Haolun123/Self-Navigation-Robot/README

This is for self-navigation robot, sensors and algorithm can look at the report. 
Will include the video.
