Haolun123/Self-Navigation-Robot/README.txt

This is for self-navigation robot, sensors and algorithm can look at the report. 
Will include the video.
https://www.youtube.com/watch?v=NngwBFYdkD8
