Haolun123/Self-Navigation-Robot/(notices)

Notices in the files:
sketch_may02a.ino:
This program is free software: you can redistribute it and/or modify
it under the terms of the version 3 GNU General Public License as
published by the Free Software Foundation.
